M2I-CySat/CSK-Motherboard/pinout.pdf

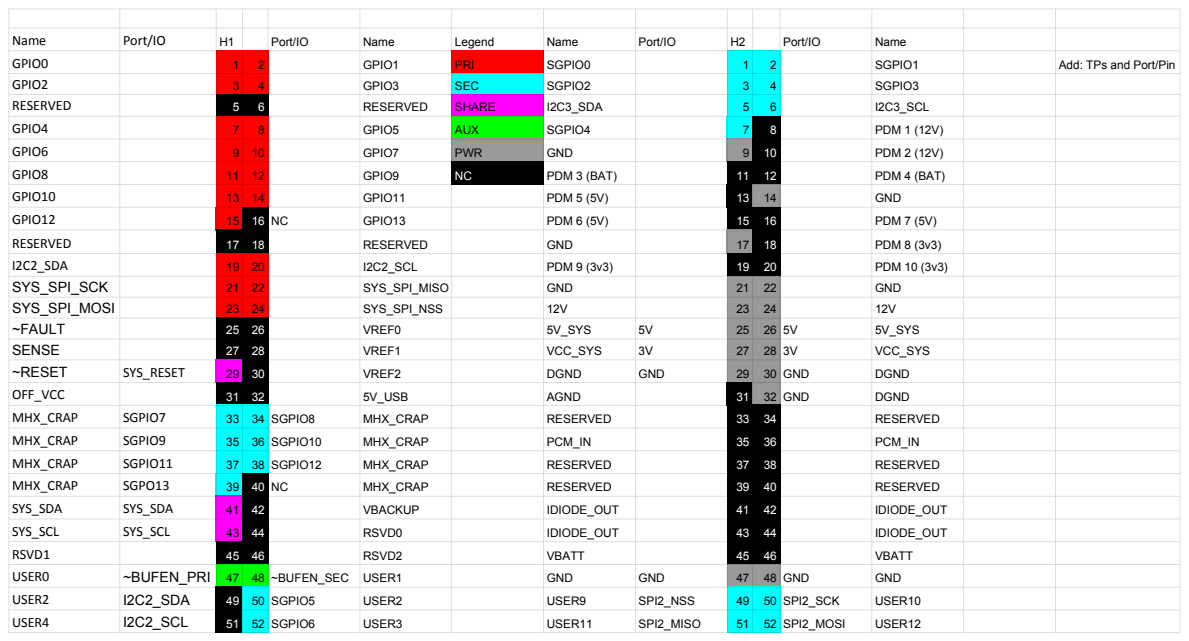
[picture p1: page 1]
Name; Port/IO; Legend; GPIO0; GPIO1; PRI; SGPIO0; SGPIO1; Add: TPs and Port/Pin; GPIO2; GPIO3; SEC; SGPIO2; SGPIO3; RESERVED; SHARE; I2C3_SDA; I2C3_SCL; GPIO4; GPIO5; AUX; SGPIO4; PDM 1 (12V); GPIO6; GPIO7; PWR; GND; PDM 2 (12V); GPIO8; GPIO9; PDM 3 (BAT); PDM 4 (BAT); GPIO10; GPIO11; PDM 5 (5V); GPIO12; GPIO13; PDM 6 (5V); PDM 7 (5V); PDM 8 (3v3); I2C2_SDA; I2C2_SCL; PDM 9 (3v3); PDM 10 (3v3); SYS_SPI_SCK; SYS_SPI_MISO; SYS_SPI_MOSI; SYS_SPI_NSS; ~FAULT; VREF0; 5V_SYS; SENSE; VREF1; VCC_SYS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
