M2I-CySat/CSK-Motherboard/motherboard.pdf

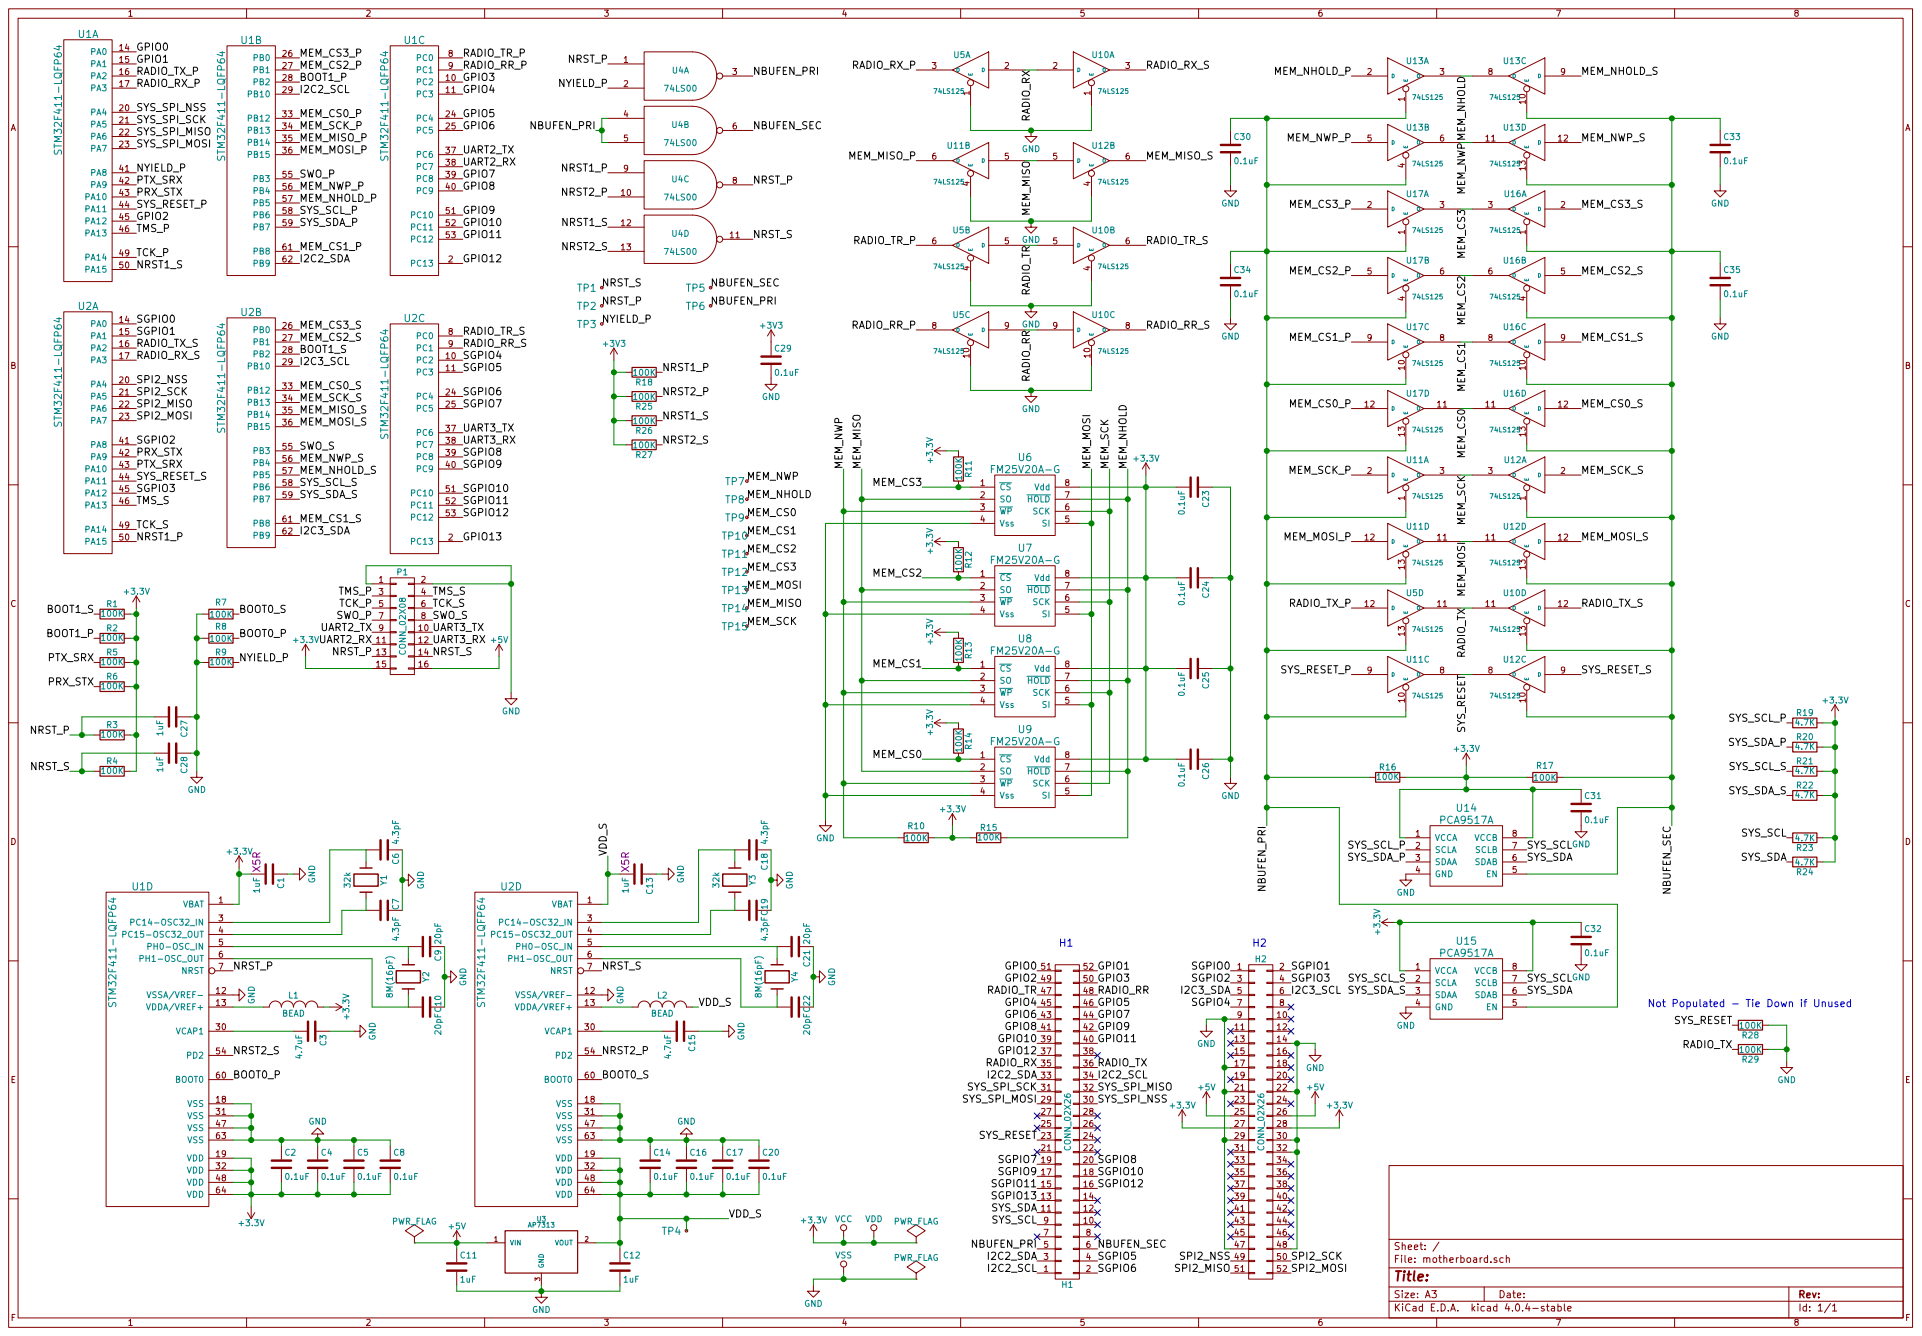
[picture p2: page 1]

Not Populated - Tie Down if Unused
100K SYS_RESET

Id: 1/1 Title: File: motherboard.sch Sheet: /
