M2I-CySat/CSK-Motherboard/motherboard.kicad_pcb

## KiCad design motherboard.kicad_pcb (2018-07-30)

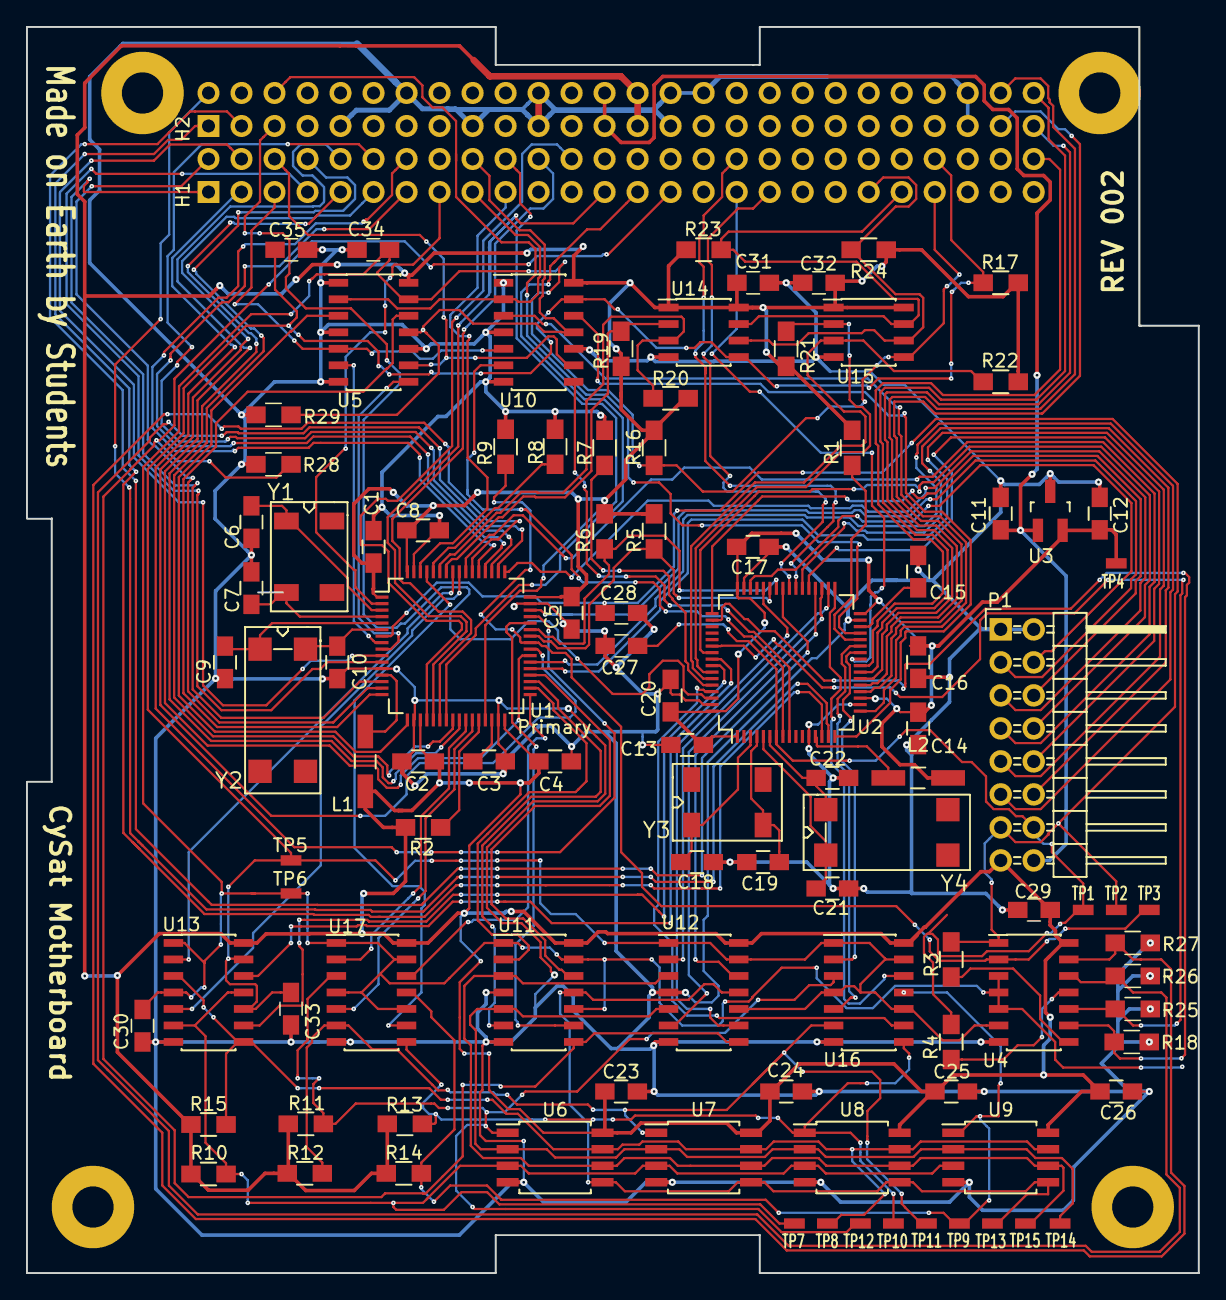
[picture p3: board motherboard.kicad_pcb from above]

Board: 2 copper layers, 90.2 x 95.9 mm, 106 parts (1 on the bottom side), 123 nets.

Parts:
C1, C11, C12, C13, C27, C28: 1uF; C_0805_HandSoldering
C2, C4, C5, C8, C14, C16, C17, C20, C23, C24, C25, C26, C29, C30, C31, C32, C33, C34, C35: 0.1uF; C_0805_HandSoldering
C3, C15: 4.7uF; C_0805_HandSoldering
C6, C7, C18, C19: 4.3pF; C_0805_HandSoldering
C9, C10, C21, C22: 20pF; C_0805_HandSoldering
H1, H2: CONN_02X26; CSK_Header
L1, L2: BEAD; Choke_SMD_1206_Handsoldering
LOGO: LOGO
P1: CONN_02X08; Pin_Header_Angled_2x08
R1, R2, R3, R4, R5, R6, R7, R8, R9, R10, R11, R12, R13, R14, R15, R16, R17, R18, R25, R26, R27, R28, R29: 100K; R_0805_HandSoldering
R19, R20, R21, R22, R23, R24: 4.7K; R_0805_HandSoldering
TP1, TP2, TP3, TP4, TP5, TP6, TP7, TP8, TP9, TP10, TP11, TP12, TP13, TP14, TP15: TP; TP_0603
U1, U2: STM32F411-LQFP64; LQFP-64_10x10mm_Pitch0.5mm
U3: AP7313; SOT-23_Handsoldering
U4: 74LS00; SOIC-14_3.9x8.7mm_Pitch1.27mm
U5, U10, U11, U12, U13, U16, U17: 74LS125; SOIC-14_3.9x8.7mm_Pitch1.27mm
U6, U7, U8, U9: FM25V20A-G; SOIJ-8_5.3x5.3mm_Pitch1.27mm
U14, U15: PCA9517A; SOIC-8_3.9x4.9mm_Pitch1.27mm
Y1, Y3: 32k; SOJ-4_5.5mm
Y2, Y4: 8M(16pF); SOJ-4_9.4mm

Connections:
+3V3: C1.2, C2.2, C4.2, C5.2, C8.2, C23.2, C24.2, C25.2, C26.2, C29.1, C31.1, C32.1, H2.27, H2.28, L1.2, P1.15, R1.2, R2.2, R5.2, R6.2, R10.1, R11.1, R12.1, R13.1, R14.1, R15.1, R16.2, R17.2, R19.2, R20.2, R21.2, R22.2, R23.1, R24.1, U1.1, U1.19, U1.32, U1.48, U1.64, U4.14, U5.14, U6.8, U7.8, U8.8, U9.8, U10.14, U11.14, U12.14, U13.14, U14.1, U14.8, U15.1, U15.8, U16.14, U17.14
+5V: C11.1, H2.25, H2.26, P1.16, U3.1
/BOOT0_P: R8.1, U1.60
/BOOT0_S: R7.1, U2.60
/BOOT1_P: R2.1, U1.28
/BOOT1_S: R1.1, U2.28
/GPIO0: H1.1, U1.14
/GPIO1: H1.2, U1.15
/GPIO2: H1.3, U1.45
/GPIO3: H1.4, U1.10
/GPIO4: H1.7, U1.11
/GPIO5: H1.8, U1.24
/GPIO6: H1.9, U1.25
/GPIO7: H1.10, U1.39
/GPIO8: H1.11, U1.40
/GPIO9: H1.12, U1.51
/GPIO10: H1.13, U1.52
/GPIO11: H1.14, U1.53
/GPIO12: H1.15, U1.2
/I2C2_SCL: H1.20, U1.29
/I2C2_SDA: H1.19, U1.62
/I2C3_SCL: H2.6, U2.29
/I2C3_SDA: H2.5, U2.62
/MEM_CS0: R14.2, TP9.1, U9.1, U16.11, U17.11
/MEM_CS0_P: U1.33, U17.12
/MEM_CS0_S: U2.33, U16.12
/MEM_CS1: R13.2, TP10.1, U8.1, U16.8, U17.8
/MEM_CS1_P: U1.61, U17.9
/MEM_CS1_S: U2.61, U16.9
/MEM_CS2: R12.2, TP11.1, U7.1, U16.6, U17.6
/MEM_CS2_P: U1.27, U17.5
/MEM_CS2_S: U2.27, U16.5
/MEM_CS3: R11.2, TP12.1, U6.1, U16.3, U17.3
/MEM_CS3_P: U1.26, U17.2
/MEM_CS3_S: U2.26, U16.2
/MEM_MISO: TP14.1, U6.2, U7.2, U8.2, U9.2, U11.5, U12.5
/MEM_MISO_P: U1.35, U11.6
/MEM_MISO_S: U2.35, U12.6
/MEM_MOSI: TP13.1, U6.5, U7.5, U8.5, U9.5, U11.11, U12.11
/MEM_MOSI_P: U1.36, U11.12
/MEM_MOSI_S: U2.36, U12.12
/MEM_NHOLD: R15.2, TP8.1, U6.7, U7.7, U8.7, U9.7, U13.3, U13.8
/MEM_NHOLD_P: U1.57, U13.2
/MEM_NHOLD_S: U2.57, U13.9
/MEM_NWP: R10.2, TP7.1, U6.3, U7.3, U8.3, U9.3, U13.6, U13.11
/MEM_NWP_P: U1.56, U13.5
/MEM_NWP_S: U2.56, U13.12
/MEM_SCK: TP15.1, U6.6, U7.6, U8.6, U9.6, U11.3, U12.3
/MEM_SCK_P: U1.34, U11.2
/MEM_SCK_S: U2.34, U12.2
/NBUFEN_PRI: C30.1, C34.1, H1.45, R16.1, TP6.1, U4.3, U4.4, U4.5, U5.13, U11.1, U11.10, U11.13, U13.1, U13.4, U15.5, U17.1, U17.4, U17.10, U17.13
/NBUFEN_SEC: C33.1, C35.1, H1.46, R17.1, TP5.1, U4.6, U10.13, U12.1, U12.10, U12.13, U13.10, U13.13, U14.5, U16.1, U16.4, U16.10, U16.13
/NRST_P: C27.2, P1.13, R3.2, TP2.1, U1.7, U4.1
/NRST_S: C28.2, P1.14, R4.2, TP1.1, U2.7
/NYIELD_P: R9.1, TP3.1, U1.41, U4.2
/PRX_STX: R6.1, U1.43, U2.42
/PTX_SRX: R5.1, U1.42, U2.43
/RADIO_RR: H1.6, U5.9, U10.9
/RADIO_RR_P: U1.9, U5.8
/RADIO_RR_S: U2.9, U10.8
/RADIO_RX: H1.17, U5.2, U10.2
/RADIO_RX_P: U1.17, U5.3
/RADIO_RX_S: U2.17, U10.3
/RADIO_TR: H1.5, U5.5, U10.5
/RADIO_TR_P: U1.8, U5.6
/RADIO_TR_S: U2.8, U10.6
/RADIO_TX: H1.18, R29.2, U5.11, U10.11
/RADIO_TX_P: U1.16, U5.12
/RADIO_TX_S: U2.16, U10.12
/RST1_P: R18.1, U2.50, U4.9
/RST1_S: R26.1, U1.50, U4.12
/RST2_P: R25.1, U2.54, U4.10
/RST2_S: R27.1, U1.54, U4.13
/SGPIO0: H2.1, U2.14
/SGPIO1: H2.2, U2.15
/SGPIO2: H2.3, U2.41
/SGPIO6: H1.52, U2.24
/SGPIO7: H1.33, U2.25
/SGPIO8: H1.34, U2.39
/SGPIO9: H1.35, U2.40
/SPI2_MISO: H2.51, U2.22
/SPI2_MOSI: H2.52, U2.23
/SPI2_NSS: H2.49, U2.20
/SPI2_SCK: H2.50, U2.21
/SWO_P: P1.7, U1.55
/SWO_S: P1.8, U2.55
/SYS_RESET: H1.29, R28.2, U11.8, U12.8
/SYS_RESET_P: U1.44, U11.9
/SYS_RESET_S: U2.44, U12.9
/SYS_SCL: H1.43, R23.2, U14.7, U15.7
/SYS_SCL_P: R19.1, U1.58, U14.2
/SYS_SCL_S: R21.1, U2.58, U15.2
/SYS_SDA: H1.41, R24.2, U14.6, U15.6
/SYS_SDA_P: R20.1, U1.59, U14.3
/SYS_SDA_S: R22.1, U2.59, U15.3
/SYS_SPI_MISO: H1.22, U1.22
/SYS_SPI_MOSI: H1.27, U1.23
/SYS_SPI_NSS: H1.24, U1.20
/SYS_SPI_SCK: H1.25, U1.21
/TCK_P: P1.5, U1.49
/TCK_S: P1.6, U2.49
/TMS_P: P1.3, U1.46
/TMS_S: P1.4, U2.46
/UART2_RX: P1.11, U1.38
/UART2_TX: P1.9, U1.37
/UART3_RX: P1.12, U2.38
/UART3_TX: P1.10, U2.37
/VDD_S: C12.1, C13.2, C14.2, C16.2, C17.2, C20.2, L2.2, TP4.1, U2.1, U2.19, U2.32, U2.48, U2.64, U3.2
GND: C1.1, C2.1, C3.1, C4.1, C5.1, C6.1, C7.1, C8.1, C9.1, C10.1, C11.2, C12.2, C13.1, C14.1, C15.1, C16.1, C17.1, C18.1, C19.1, C20.1, C21.1, C22.1, C23.1, C24.1, C25.1, C26.1, C27.1, C28.1, C29.2, C30.2, C31.2, C32.2, C33.2, C34.2, C35.2, H2.9, H2.14, H2.17, H2.21, H2.22, H2.29, H2.30, H2.32, H2.47, H2.48, P1.1, P1.2, R7.2, R8.2, R9.2, R18.2, R25.2, R26.2, R27.2, R28.1, R29.1, U1.12, U1.18, U1.31, U1.47, U1.63, U2.12, U2.18, U2.31, U2.47, U2.63, U3.3, U4.7, U5.1, U5.4, U5.7, U5.10, U6.4, U7.4, U8.4, U9.4, U10.1, U10.4, U10.7, U10.10, U11.4, U11.7, U12.4, U12.7, U13.7, U14.4, U15.4, U16.7, U17.7
unnamed: C3.2, U1.30
unnamed: C6.2, U1.3, Y1.1
unnamed: C7.2, U1.4, Y1.2
unnamed: C9.2, U1.5, Y2.1
unnamed: C10.2, U1.6, Y2.2
unnamed: C15.2, U2.30
unnamed: C18.2, U2.3, Y3.1
unnamed: C19.2, U2.4, Y3.2
unnamed: C21.2, U2.5, Y4.1
unnamed: C22.2, U2.6, Y4.2
unnamed: L1.1, U1.13
unnamed: L2.1, U2.13
unnamed: R3.1, U4.8
unnamed: R4.1, U4.11
