M2I-CySat/CSK-Motherboard/rev2issues.txt

Issues:
Add restart button
Add LED
Add ground to case
Fix driving of the reset lines directly by a 7400 chip
NRST 1 and NRST 2 are currently pulled up and need to be pulled down
MISO for mem spi doesnt have pull up or pull down

Do we need to add vias?
Change from 3.3 to gnd on Resistors 28 and adj
Find stacking headers on digikey
