M2I-CySat/CSK-Motherboard/(commit log)

2016-01-31 Work done on buffers and MCU placement
    [connectors.sch, motherboard.sch, power-misc.sch]
2016-02-23 Did some stuff
    [connectors.sch, motherboard.sch, power-misc.sch]
2016-02-23 Began adding memory
    [motherboard.sch, power-misc.sch]
2016-02-24 Put FRAM on motherboard
    [motherboard.sch]
2016-03-13 Work on schematic
    [motherboard.sch]
2016-03-13 Very nearly done
    [motherboard.sch]
2016-03-14 Shit's done, yo
    The schematic, that is.
    [motherboard.sch]
2016-11-05 Began adding real connectors to schematic
    [motherboard.sch]
2016-11-29 Added radio interrupt lines
    [motherboard.sch]
2016-11-30 Associated symbols with footprints
    Created a few modules as needed
    [motherboard.sch]
2016-11-30 Design rules
    [motherboard.kicad_pcb, motherboard.sch]
2016-12-03 Started BOM
    [bom.xlsx]
2016-12-03 Finished board outline and connector placement
    Beginning to assign GPIOs and layout components
    [motherboard.kicad_pcb, motherboard.sch]
2016-12-04 Schematic passes DRC
    [motherboard.sch]
2016-12-04 Progress in laying out components
    [motherboard.kicad_pcb, motherboard.sch]
2016-12-05 Placed all components
    [motherboard.kicad_pcb, motherboard.sch]
2017-02-03 Routed P1 High-speed signals
    - Main UART
    - Main I2C
    - Mem SPI
    [motherboard.kicad_pcb, motherboard.sch]
2017-02-03 Much more routing completed.
    [motherboard.kicad_pcb]
2017-02-05 More routing
    [motherboard.kicad_pcb]
2017-04-08 Added boards to datasheets
2017-04-08 Added STM32 datasheet
2017-04-22 Implemented recommendations from design meeting.
    [motherboard.sch]
2017-04-22 Began placing new components
    [motherboard.kicad_pcb, motherboard.sch]
2017-04-26 All components placed
    Most signals routed
    [motherboard.kicad_pcb, motherboard.sch]
2017-04-26 Plotted PDF and gerbers
    [motherboard-B.Cu.gbl, motherboard-B.Mask.gbs, motherboard-B.SilkS.gbo, motherboard-Edge.Cuts.gm1, motherboard-F.Cu.gtl, motherboard-F.Mask.gts, motherboard-F.SilkS.gto, motherboard.drl]
2017-09-15 Replaced backwards CSK headers
    Connectors were mirrored, so that sucks. Connectors replaced,
    but all traces to headers need to be re-routed.
    [motherboard.kicad_pcb, motherboard.sch]
2017-10-08 Primary GPIO routed
    [motherboard.kicad_pcb, motherboard.sch]
2017-10-09 Added silkscreen revision tag
    [motherboard.kicad_pcb]
2017-10-16 Add a preliminary bill of materials
    [motherboard_bom_.csv]
2017-11-01 Started Digi-Key part numbers
    [motherboard.kicad_pcb, motherboard_bom_.csv]
2017-11-03 Finished DigiKey part numbers
    [motherboard_bom_.csv]
2017-11-04 Removed fake BoM
    [bom.xlsx]
2018-03-29 Fixed wireplacement, moved values to facilitate eaiser assembly, Added text and logo
    [motherboard.kicad_pcb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]
2018-03-30 Removed tumor
    [motherboard.kicad_pcb]
2018-04-07 Added footprint directory
    [motherboard.sch]
2018-04-07 Added footprint directory part deux
    [FM25V20A-G.stl, FM25V20A-G.stp]
2018-04-07 Adding ground plane
    [motherboard.kicad_pcb, motherboard.sch]
2018-04-07 Added ground plane and fixed footprints
    [_saved_motherboard.sch, motherboard.kicad_pcb]
2018-04-07 added logo to footprints
2018-04-07 Fixed pull-ups on NRST lines
    Also fixed naming of RSTn_m lines.
    [_saved_motherboard.sch, motherboard.sch]
2018-04-08 Partial rerouting following resistor movement
    Moving the fixed Pull-Up resistors to NAND output made a bunch of
    traces have to move.
    Not yet complete.
    [FM25V20A-G.stl, FM25V20A-G.stp, motherboard.kicad_pcb, motherboard.sch]
2018-04-08 Nuked gerber
    [motherboard-B.Cu.gbl, motherboard-B.Mask.gbs, motherboard-B.SilkS.gbo, motherboard-Edge.Cuts.gm1, motherboard-F.Cu.gtl, motherboard-F.Mask.gts, motherboard-F.Paste.gtp, motherboard-F.SilkS.gto]
2018-04-08 Finished Rev2 reworks
    - Addressed documented issues
    - Some SGPIO is not connected (see schematic for details)
    - Created direct return paths for MEM_SPI
    [motherboard.kicad_pcb, motherboard.sch]
2018-04-09 Changed revision number on board
    [motherboard.kicad_pcb]
2018-04-09 Ran DRC, checking for changes
    [motherboard.kicad_pcb]
2018-06-15 Updated bom
    [motherboard_bom_.csv]
2018-07-28 Fixed pc104 conflicts
    [_saved_motherboard.sch, motherboard-2018-07-28-15-59-06.sch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]
2018-07-30 Fixed gerber files
    [motherboard-B.Cu.gbl, motherboard-B.Mask.gbs, motherboard-B.SilkS.gbo, motherboard-Edge.Cuts.gm1, motherboard-F.Cu.gtl, motherboard-F.Mask.gts, motherboard-F.Paste.gtp, motherboard-F.SilkS.gto]
